TelecomParistoc/Wall-e/doc/wall-e_schematic.pdf

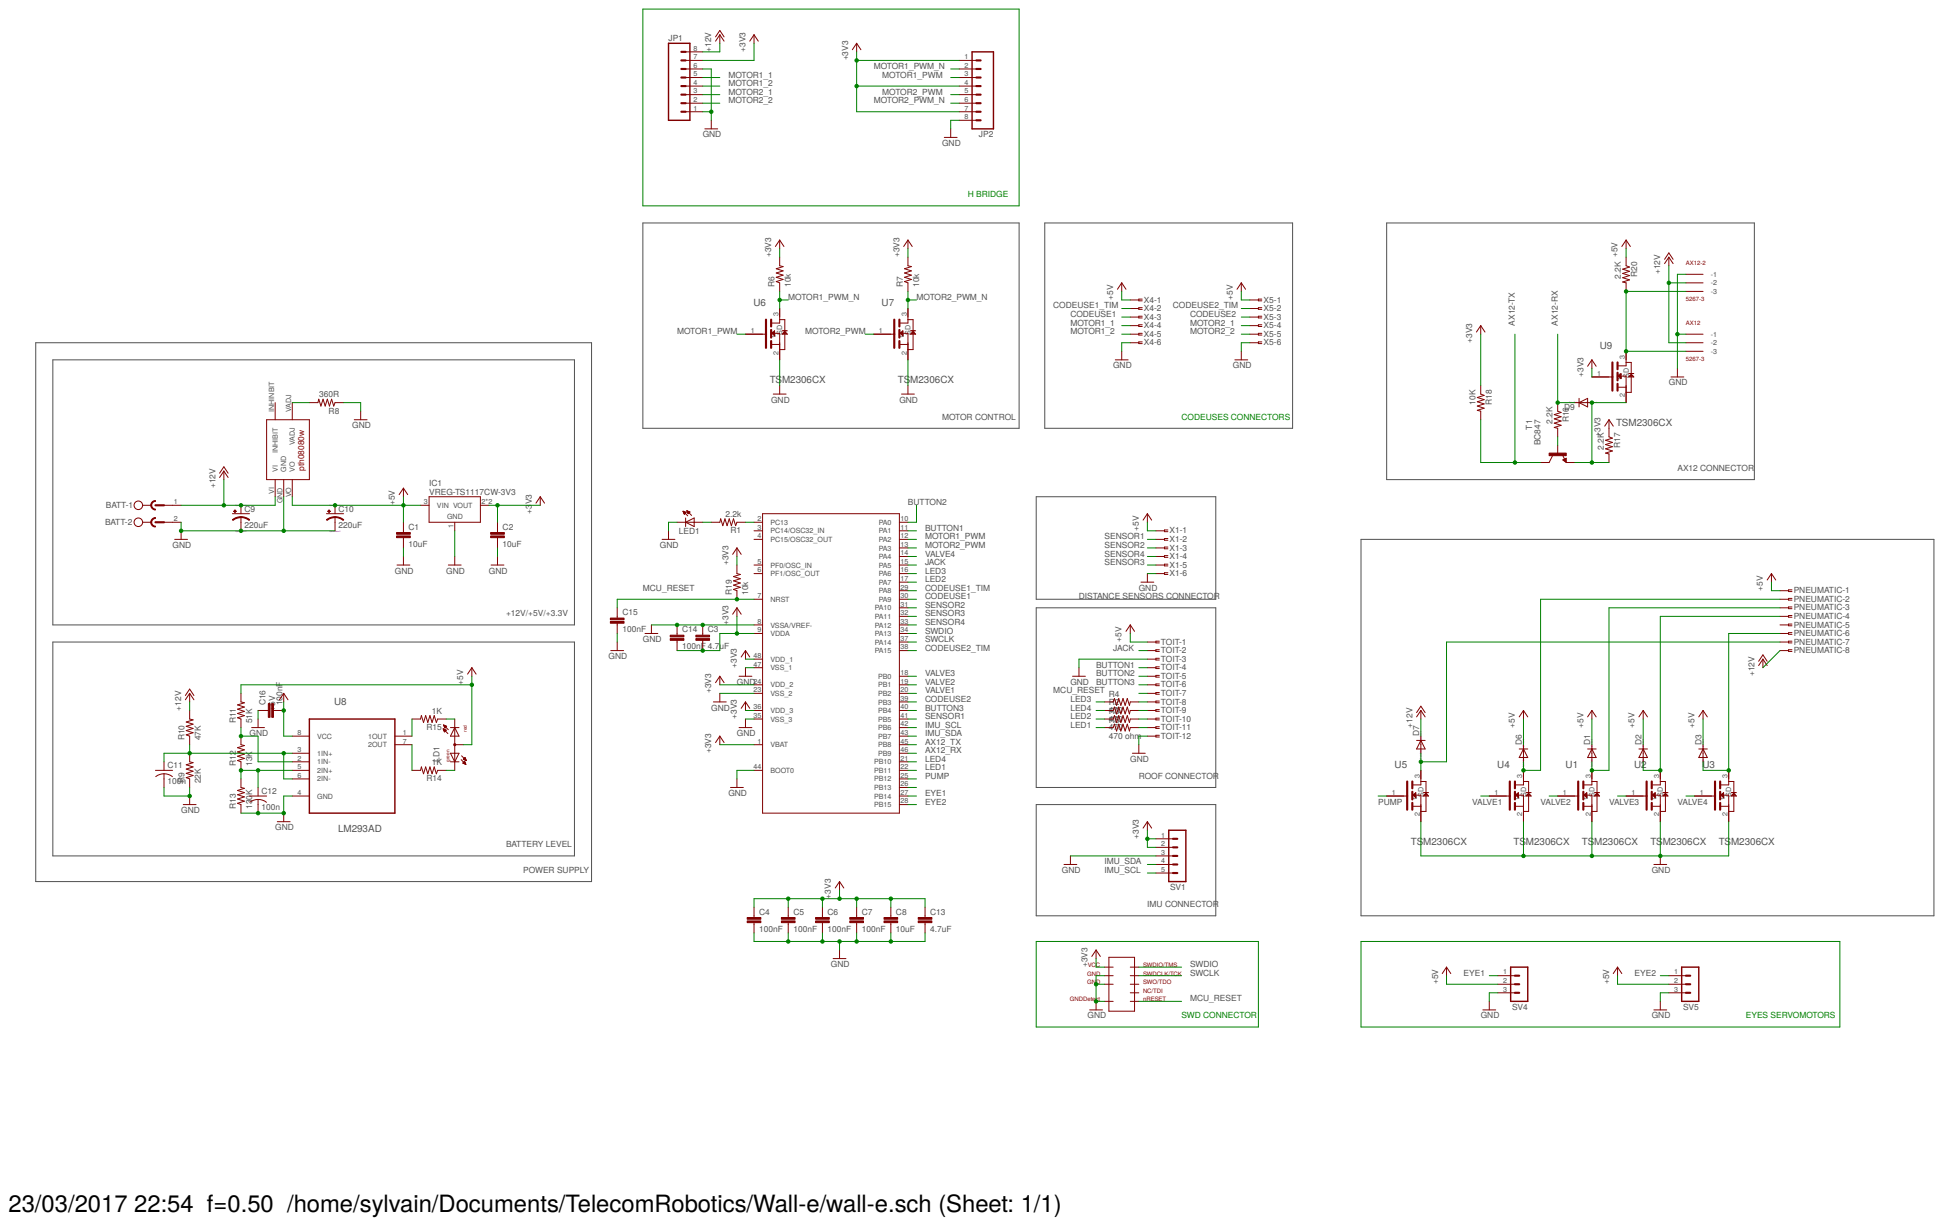
[picture p1: page 1]

VI VI GND GND

23/03/2017 22:54 f=0.50 /home/sylvain/Documents/TelecomRobotics/Wall-e/wall-e.sch (Sheet: 1/1)
