TelecomParistoc/Wall-e/doc/wall-e_bottom.pdf

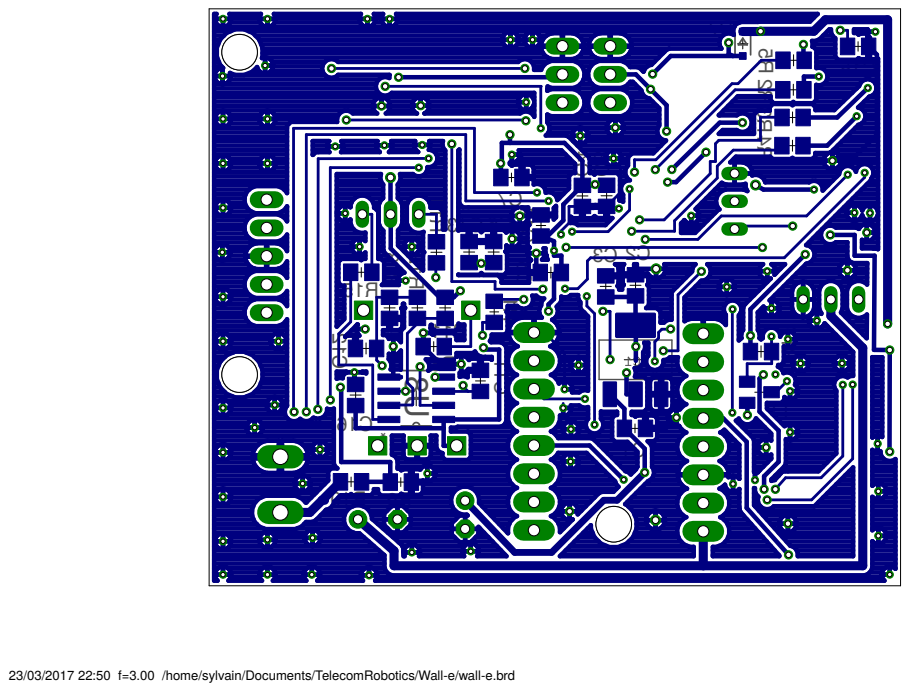
[picture p2: page 1]

23/03/2017 22:50 f=3.00 /home/sylvain/Documents/TelecomRobotics/Wall-e/wall-e.brd
