TelecomParistoc/Wall-e/doc/wall-e_top.pdf

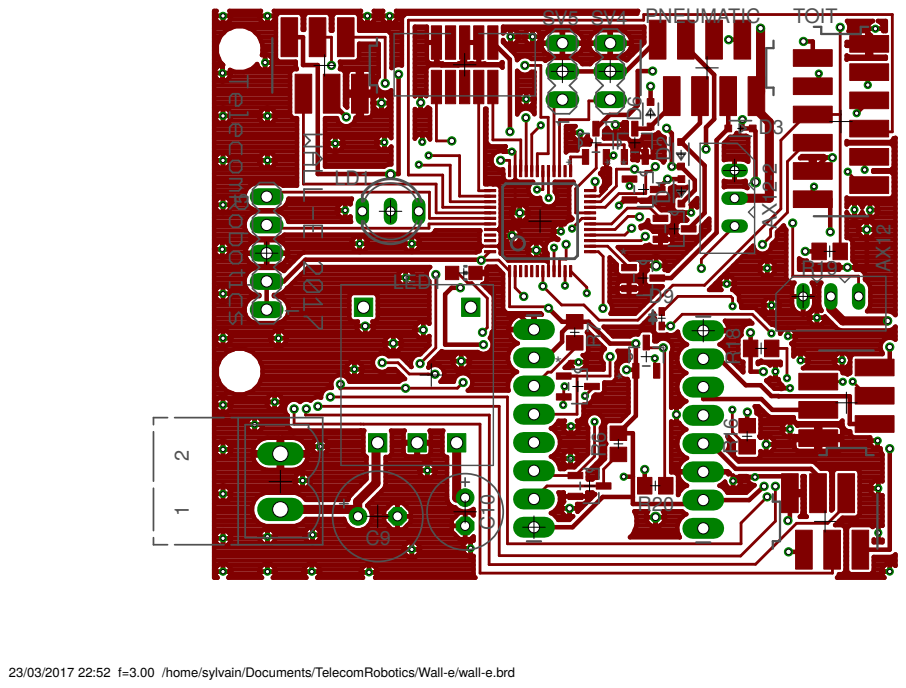
[picture p3: page 1]

23/03/2017 22:52 f=3.00 /home/sylvain/Documents/TelecomRobotics/Wall-e/wall-e.brd
