TelecomParistoc/Wall-e/elec/wall-e.brd

## EAGLE design elec/wall-e.brd (2017-04-03)

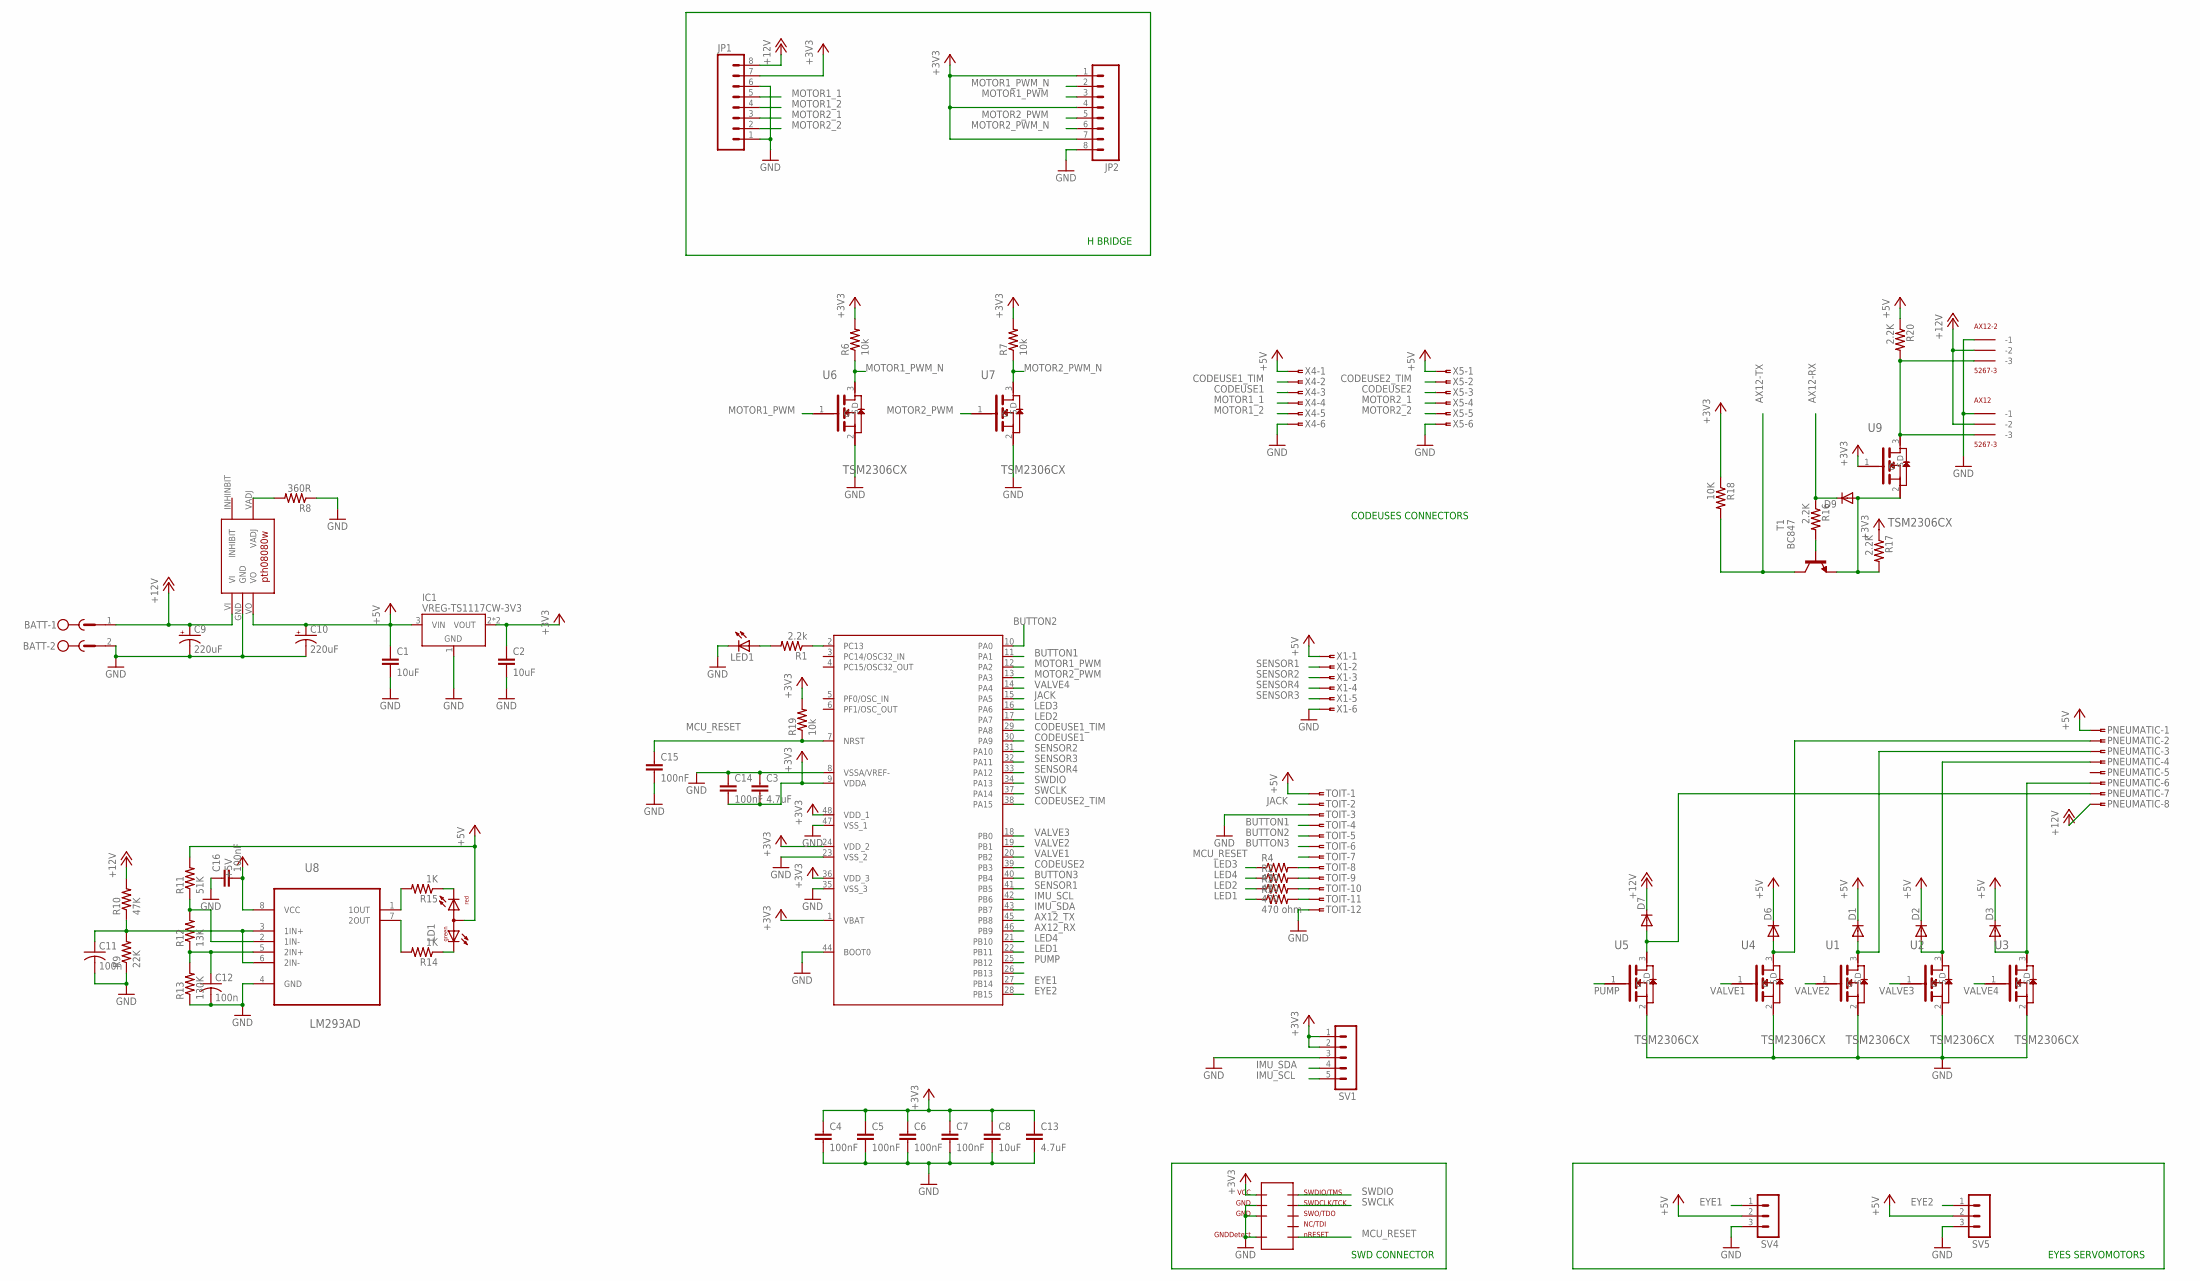
[picture p4: schematic wall-e.sch]

Parts:
AX12, AX12-2: 5267-3
BATT: MSTBV2
C1, C2, C8: 10uF; C0805
C3, C13: 4.7uF; C0805
C4, C5, C6, C7, C14, C15, C16: 100nF; C0805
C9: 220uF; E3,5-8
C10: 220uF; E2,5-7
C11, C12: 100n; C0805
D1, D2, D3, D6, D7: DIODE-SOD323-R; SOD323-R
D9: DIODE-SOD523; SOD523
IC1: VREG-TS1117CW-3V3; SOT223
JP1, JP2: M08LONGPADS; 1X08_LONGPADS
LD1: DUOLED-RG-A; DUOLED-A-5MM
LED1: LEDCHIP-LED0805; CHIP-LED0805
PNEUMATIC: SMDTOP-8; SMDTOP8
R1: 2.2k; R0805
R2, R3, R4: 470; R0805
R5: 470 ohm; R0805
R6, R7, R19: 10k; R0805
R8: 360R; R0805
R9: 22K; R0805
R10: 47K; R0805
R11: 51K; R0805
R12: 13K; R0805
R13: 130K; R0805
R14, R15: 1K; R0805
R16, R17, R20: 2.2K; R0805
R18: 10K; R0805
SV1: MA05-1
SV4, SV5: MA03-1
T1: BC847; SOT23
TOIT: SMDTOP-12; SMDTOP12
U1, U2, U3, U4, U5, U6, U7, U9: TSM2306CX; SOT95P280X130-3N
U8: LM293AD; SOIC127P600X175-8N
U$1: STM32F301C8; TQFP48
U$2: REGUL_PTH
U$3: SWD/JTAG-_PINS; SAMTEC_SHF-105-01-L-D-SM
X1, X4, X5: SMDTOP-6; SMDTOP6

Connections:
+3V3: C2.1, C3.2, C4.1, C5.1, C6.1, C7.1, C8.1, C13.1, C14.2, IC1.2 (VOUT), IC1.4 (VOUT), JP1.7, JP2.1, JP2.4, JP2.7, R6.2, R7.2, R17.1, R18.1, R19.2, SV1.1, SV1.2, U9.1 (G), U$1.1 (VBAT), U$1.9 (VDDA), U$1.24 (VDD_2), U$1.36 (VDD_3), U$1.48 (VDD_1), U$3.P$1
+5V: C1.1, C10.+, C16.2, D1.C, D2.C, D3.C, D6.C, IC1.3 (VIN), LD1.A, PNEUMATIC.1, R11.2, R20.1, SV4.2, SV5.2, TOIT.1, U8.8 (VCC), U$2.VO, X1.1, X4.1, X5.1
+12V: AX12.P$2 (-2), AX12-2.P$2 (-2), BATT.1, C9.+, D7.C, JP1.8, PNEUMATIC.8, R10.2, U$2.VI
AX12-RX: D9.C, R16.1
AX12-TX: R18.2, T1.3 (C)
AX12_RX: U$1.46 (PB9)
AX12_TX: U$1.45 (PB8)
BUTTON1: TOIT.4, U$1.11 (PA1)
BUTTON2: TOIT.5, U$1.10 (PA0)
BUTTON3: TOIT.6, U$1.40 (PB4)
CODEUSE1: U$1.30 (PA9), X4.3
CODEUSE1_TIM: U$1.29 (PA8), X4.2
CODEUSE2: U$1.39 (PB3), X5.3
CODEUSE2_TIM: U$1.38 (PA15), X5.2
EYE1: SV4.1, U$1.27 (PB14)
EYE2: SV5.1, U$1.28 (PB15)
GND: AX12.P$1 (-1), AX12-2.P$1 (-1), BATT.2, C1.2, C2.2, C3.1, C4.2, C5.2, C6.2, C7.2, C8.2, C9.-, C10.-, C11.2, C12.2, C13.2, C14.1, C15.2, C16.1, IC1.1 (GND), JP1.1, JP1.6, JP2.8, LED1.C, R8.1, R9.1, R13.1, SV1.3, SV4.3, SV5.3, TOIT.3, TOIT.12, U1.2 (S), U2.2 (S), U3.2 (S), U4.2 (S), U5.2 (S), U6.2 (S), U7.2 (S), U8.4 (GND), U$1.8 (VSSA/VREF-), U$1.23 (VSS_2), U$1.35 (VSS_3), U$1.44 (BOOT0), U$1.47 (VSS_1), U$2.GND, U$3.P$3, U$3.P$5, U$3.P$9, X1.6, X4.6, X5.6
IMU_SCL: SV1.5, U$1.42 (PB6)
IMU_SDA: SV1.4, U$1.43 (PB7)
JACK: TOIT.2, U$1.15 (PA5)
LED1: R5.1, U$1.22 (PB11)
LED2: R3.1, U$1.17 (PA7)
LED3: R4.1, U$1.16 (PA6)
LED4: R2.1, U$1.21 (PB10)
MCU_RESET: C15.1, R19.1, TOIT.7, U$1.7 (NRST), U$3.P$10
MOTOR1_1: JP1.5, X4.4
MOTOR1_2: JP1.4, X4.5
MOTOR1_PWM: JP2.3, U6.1 (G), U$1.12 (PA2)
MOTOR1_PWM_N: JP2.2, R6.1, U6.3 (D)
MOTOR2_1: JP1.3, X5.4
MOTOR2_2: JP1.2, X5.5
MOTOR2_PWM: JP2.5, U7.1 (G), U$1.13 (PA3)
MOTOR2_PWM_N: JP2.6, R7.1, U7.3 (D)
unnamed: R5.2, TOIT.11
unnamed: R3.2, TOIT.10
unnamed: R2.2, TOIT.9
unnamed: R4.2, TOIT.8
unnamed: D1.A, PNEUMATIC.3, U1.3 (D)
unnamed: D2.A, PNEUMATIC.4, U2.3 (D)
unnamed: D3.A, PNEUMATIC.6, U3.3 (D)
unnamed: D6.A, PNEUMATIC.2, U4.3 (D)
unnamed: D7.A, PNEUMATIC.7, U5.3 (D)
unnamed: R1.1, U$1.2 (PC13)
unnamed: R8.2, U$2.VADJ
unnamed: R15.2, U8.1 (1OUT)
unnamed: LD1.CR, R15.1
unnamed: R14.2, U8.7 (2OUT)
unnamed: LD1.CX (CG), R14.1
unnamed: LED1.A, R1.2
unnamed: C11.1, R9.2, R10.1, U8.3 (1IN+), U8.6 (2IN-)
unnamed: R11.1, R12.2, U8.2 (1IN-)
unnamed: C12.1, R12.1, R13.2, U8.5 (2IN+)
unnamed: AX12.P$3 (-3), AX12-2.P$3 (-3), R20.2, U9.3 (D)
unnamed: R16.2, T1.1 (B)
unnamed: D9.A, R17.2, T1.2 (E), U9.2 (S)
PUMP: U5.1 (G), U$1.25 (PB12)
SENSOR1: U$1.41 (PB5), X1.2
SENSOR2: U$1.31 (PA10), X1.3
SENSOR3: U$1.32 (PA11), X1.5
SENSOR4: U$1.33 (PA12), X1.4
SWCLK: U$1.37 (PA14), U$3.P$4
SWDIO: U$1.34 (PA13), U$3.P$2
VALVE1: U4.1 (G), U$1.20 (PB2)
VALVE2: U1.1 (G), U$1.19 (PB1)
VALVE3: U2.1 (G), U$1.18 (PB0)
VALVE4: U3.1 (G), U$1.14 (PA4)

Notes on the sheet:
SWD CONNECTOR
H BRIDGE
CODEUSES CONNECTORS
EYES SERVOMOTORS

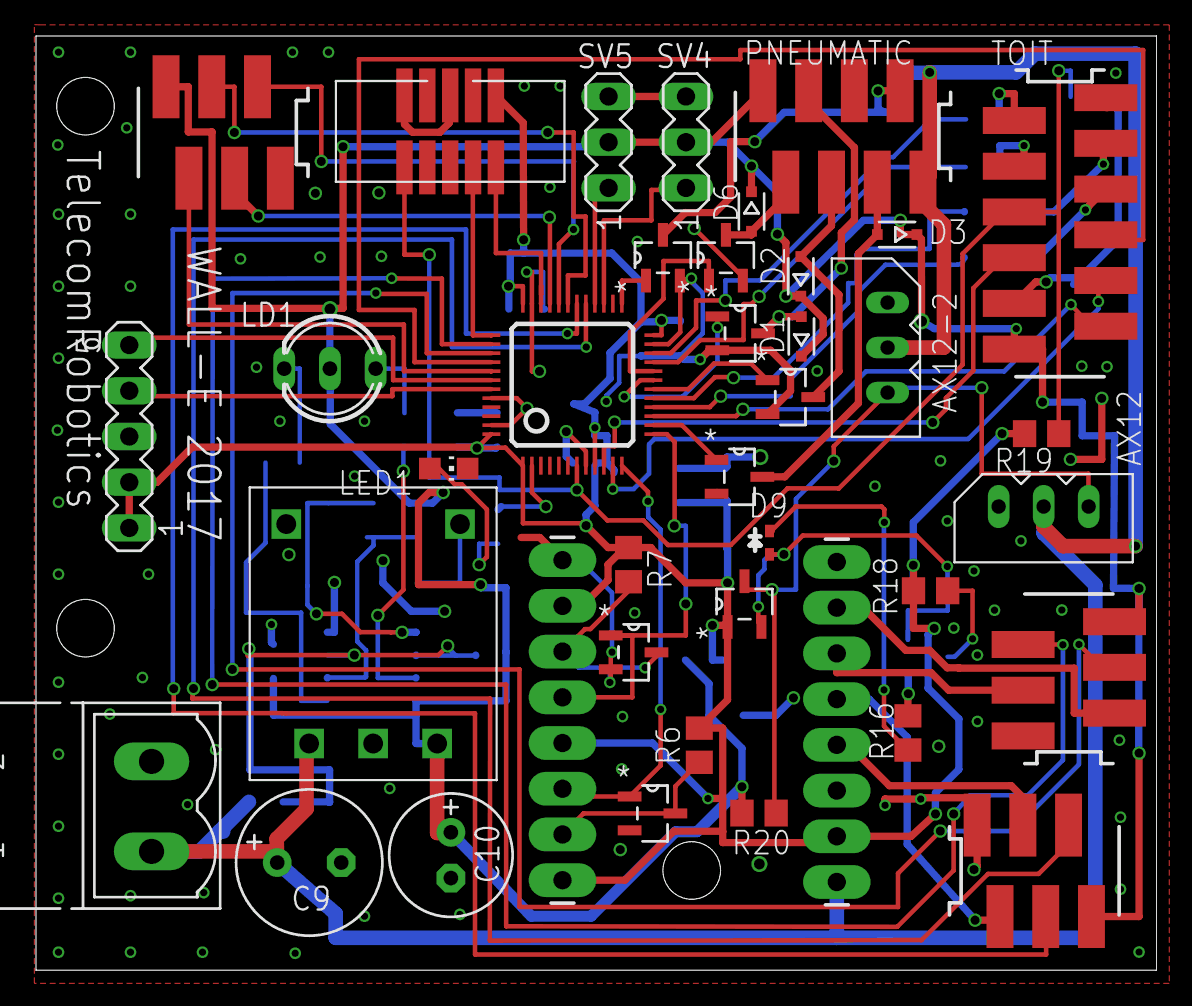
[picture p5: board wall-e.brd from above]

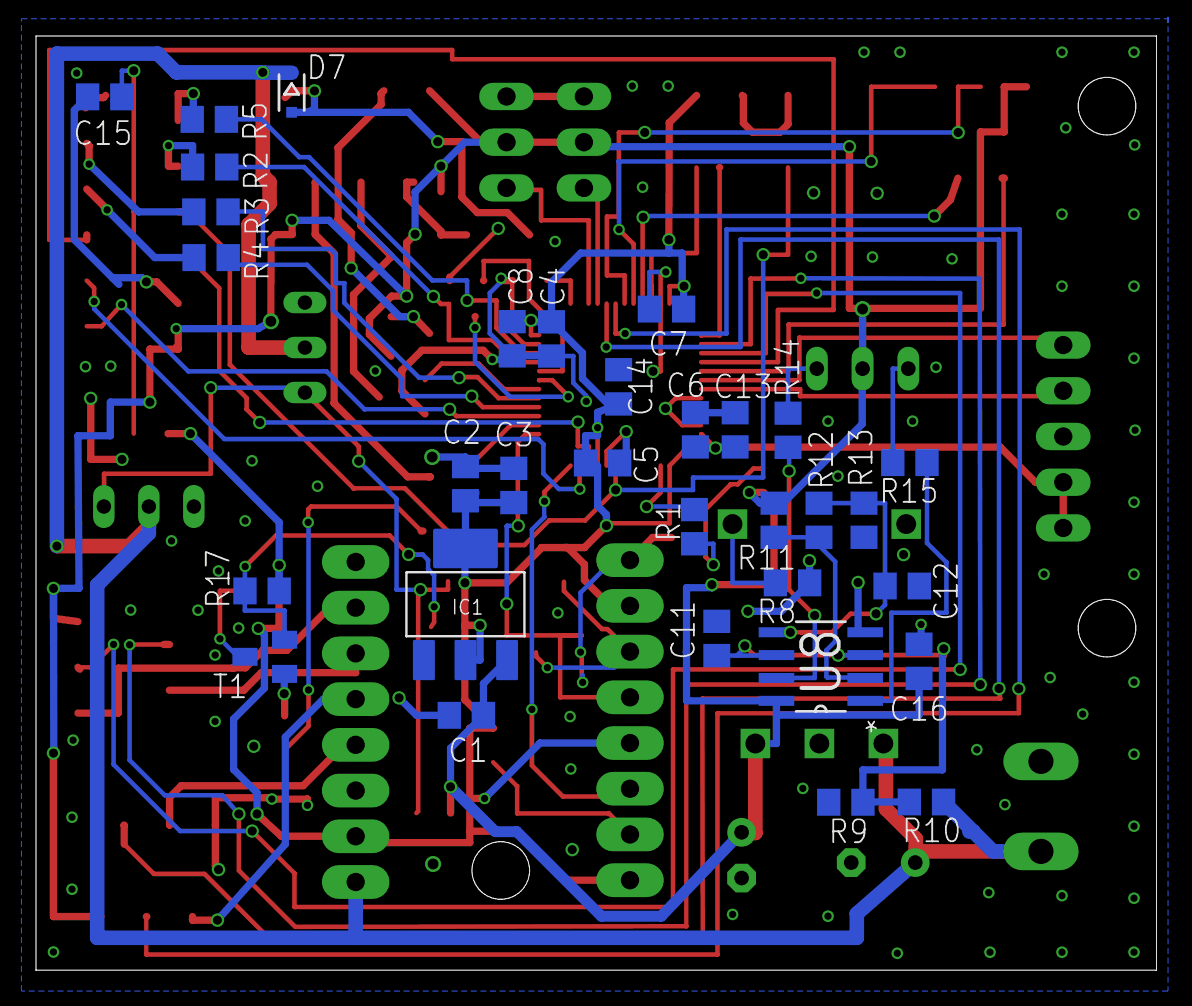
[picture p6: board wall-e.brd from below]

Board: 2 copper layers, 62.2 x 51.9 mm, 71 parts (32 on the bottom side), 64 nets.
