TelecomParistoc/Wall-e/(commit log)

2017-01-19 Addiiton of pin allocation of STM32F301 48 pins
    [table_de_routage.ods]
2017-01-19 Allocation of the pins
    [table_de_routage.ods]
2017-01-26 Beginnig of the schematic.
    [table_de_routage.ods, wall-e.sch]
2017-02-03 Second part of the schematic
    [wall-e.sch]
2017-02-17 Addition of connectors to control the motors.
    [wall-e.sch]
2017-02-17 SWD and decoupling capa
    [table_de_routage.ods, wall-e.sch]
2017-02-17 STM32 library (improved version of a cadsoft library)
2017-02-24 Addition of the AX12 control circuit and battery manager
    [wall-e.sch]
2017-02-24 Cleaning of the schematic
    [wall-e.sch]
2017-02-24 Library with SWD connector
2017-02-26 Improvement of the SWD connector in the library
2017-02-26 Addition of the JTAG device
2017-02-27 Update of the SWD connector
    [wall-e.sch]
2017-02-27 Creation of the board
    [wall-e.brd, wall-e.sch]
2017-03-05 Corrections following Arnaud's advices.
    [table_de_routage.ods, wall-e.sch]
2017-03-06 Correction of some errors (capa size and RX/TX pinout)
    [table_de_routage.ods, wall-e.sch]
2017-03-06 Correction of the board
    [wall-e.brd]
2017-03-06 Change in the H bridge
    [wall-e.brd, wall-e.sch]
2017-03-07 Last corrections on the schematic
    [wall-e.brd, wall-e.sch]
2017-03-07 Placement of the decoupling capacitor
    [wall-e.brd]
2017-03-07 Placement of main components
    [wall-e.brd]
2017-03-10 Better allocation of the pins
    [table_de_routage.ods, wall-e.brd, wall-e.sch]
2017-03-10 Update of the routing table
    [table_de_routage.ods]
2017-03-13 First DRC
    [wall-e.brd]
2017-03-14 Correction of the DRC errors
    [wall-e.brd]
2017-03-15 Some corrections
    [wall-e.brd]
2017-03-15 Minor corrections
    [wall-e.brd]
2017-03-16 Improvement of silkscreen
    [wall-e.brd]
2017-03-16 Addition of board name
    [wall-e.brd]
2017-03-19 WIP small board fixes and BOM
    [bom.csv, wall-e.brd]
2017-03-19 added distributor references
    [bom.csv]
2017-03-19 Small modification
    [bom.csv]
2017-03-20 fixed board
    [wall-e.brd, wall-e.sch]
2017-03-21 Minor changes
    [wall-e.brd]
2017-04-03 Correction of a defect found by eurocircuit (useless trace)
    [wall-e.brd]
2017-05-08 Motor control
2017-05-24 Addition of pneumatic functions
2017-12-10 Addition of IMU
2018-02-11 Addition of eyes control
    [table_de_routage.ods]
2018-03-24 Add UART protocol for IMU
